ToolKnox/hawkridge-stepper-linear-actuator-28byj48/source/upstream/images/0a723f840fd063da267f98753610b76e.png

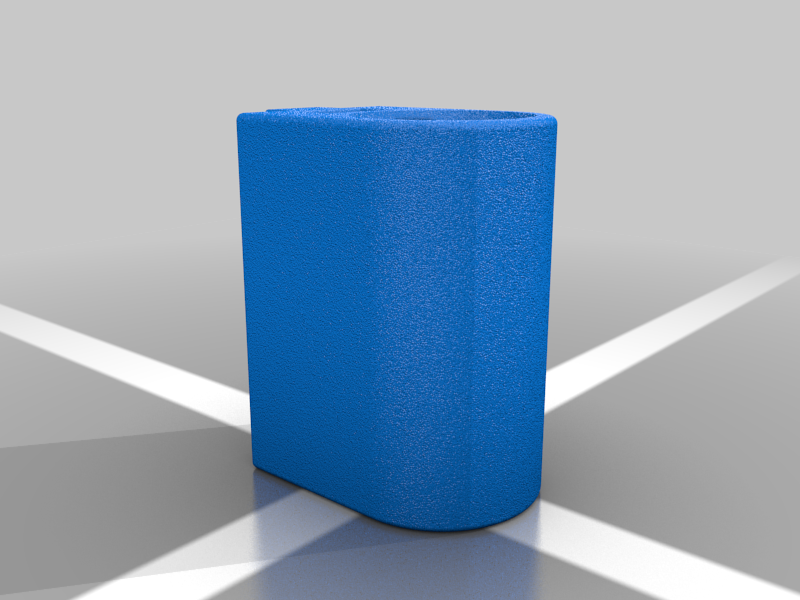
source/upstream/images/0a723f840fd063da267f98753610b76e.png
