ToolKnox/hawkridge-stepper-linear-actuator-28byj48/source/upstream/images/7eddcb1e75cd424855b5d3cada763b5f.png

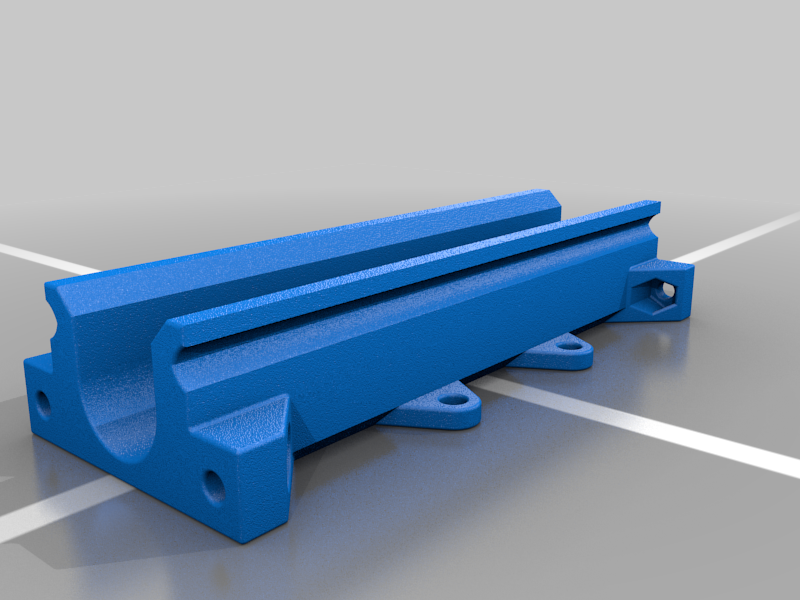
source/upstream/images/7eddcb1e75cd424855b5d3cada763b5f.png
