ToolKnox/hawkridge-stepper-linear-actuator-28byj48/source/upstream/images/86ed6450e4bb26c193aa891bc44c7ca6.png

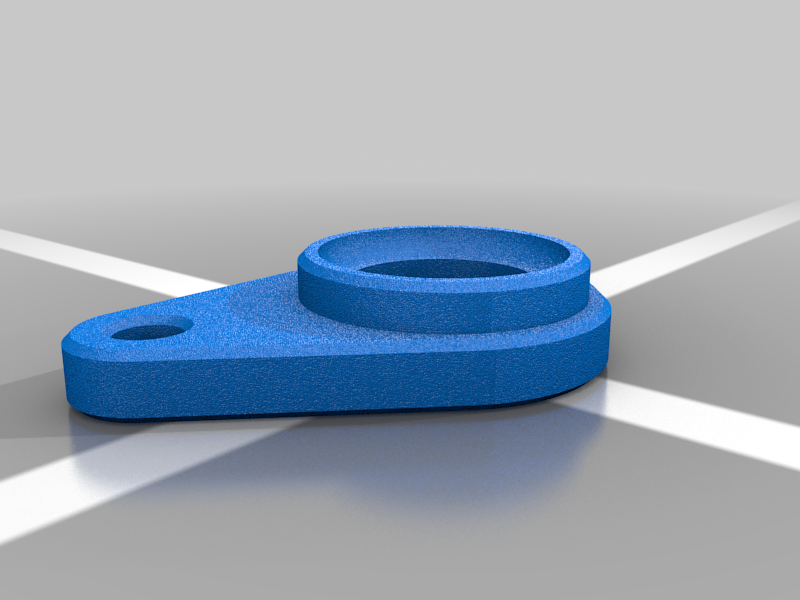
source/upstream/images/86ed6450e4bb26c193aa891bc44c7ca6.png
