ToolKnox/hawkridge-stepper-linear-actuator-28byj48/source/upstream/images/679c549c6efe19c602c5bcb0a57939a1.png

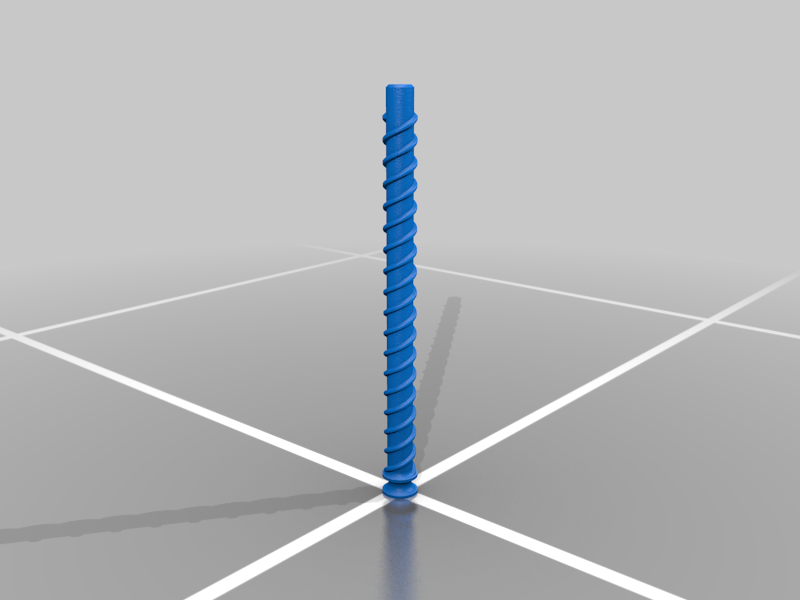
source/upstream/images/679c549c6efe19c602c5bcb0a57939a1.png
