ToolKnox/hawkridge-stepper-linear-actuator-28byj48/source/upstream/images/a1be0f932977acde7568e8e3e2db6e08.png

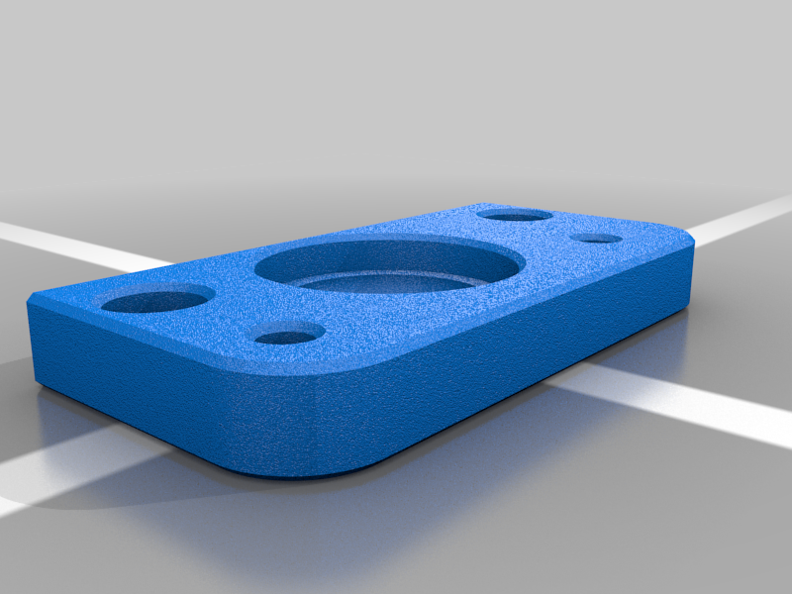
source/upstream/images/a1be0f932977acde7568e8e3e2db6e08.png
