ToolKnox/hawkridge-stepper-linear-actuator-28byj48/source/upstream/images/f5790041cac6689166ce791756fab6bf.png

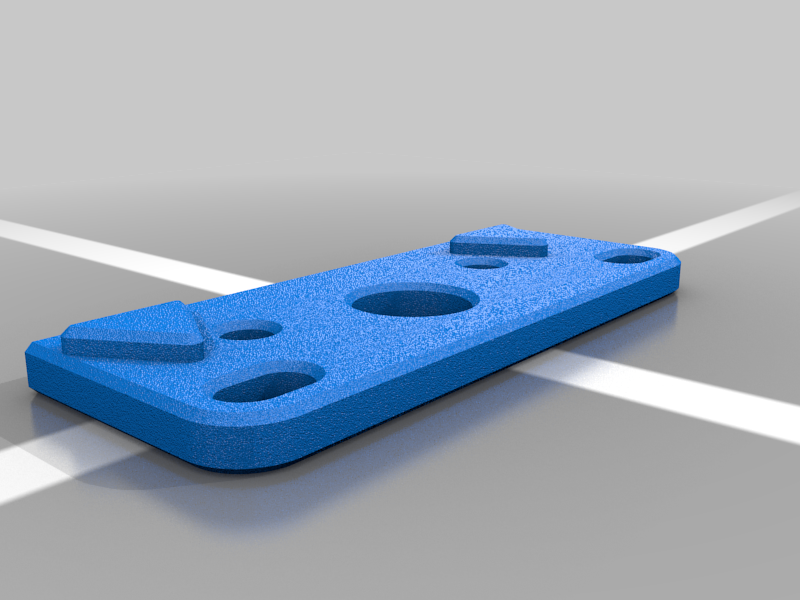
source/upstream/images/f5790041cac6689166ce791756fab6bf.png
