ToolKnox/hawkridge-stepper-linear-actuator-28byj48/source/upstream/images/fc79aa7be63a0f739bf278e467f03a53.png

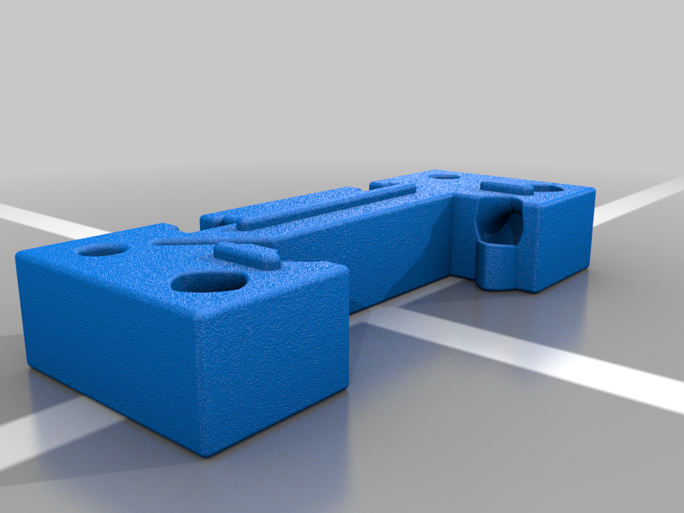
source/upstream/images/fc79aa7be63a0f739bf278e467f03a53.png
