ToolKnox/hawkridge-stepper-linear-actuator-28byj48/source/upstream/images/fd4f218f93168235e0e2fc0a6d53013b.png

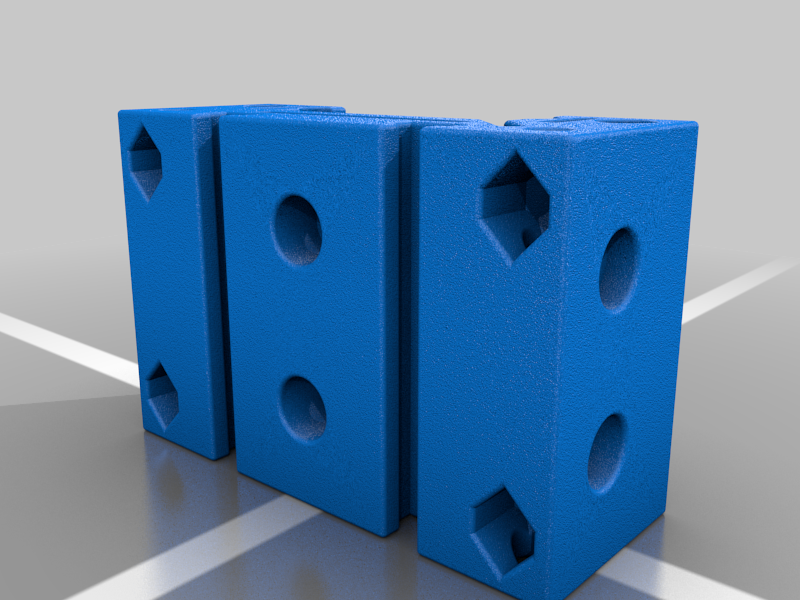
source/upstream/images/fd4f218f93168235e0e2fc0a6d53013b.png
