ToolKnox/hawkridge-stepper-linear-actuator-28byj48/source/upstream/images/IMG_7963.JPG

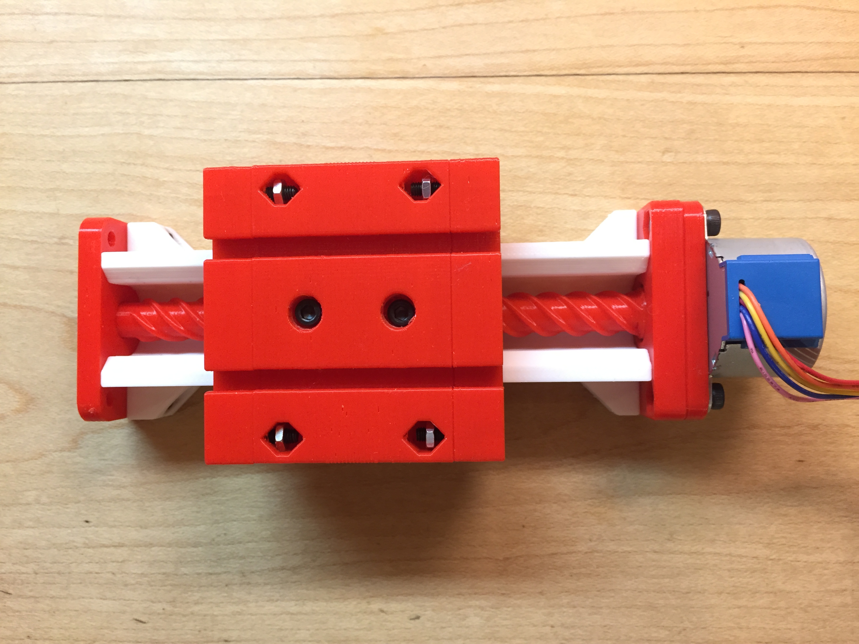
source/upstream/images/IMG_7963.JPG
