ToolKnox/hawkridge-stepper-linear-actuator-28byj48/docs/28BYJ-48 Stepper Linear Actuator with Printed Ball Screw - Bill of Material.pdf

B I L L O F M A T E R I A L S

# 28BYJ-48 Stepper Linear Actuator with Printed Ball Screw

Rev. 2026-10-20 13 items

View this project on Printables (https://www.printables.com/@TomKnox_1573/models) | Buy me a Beer (https://www.paypal.com/paypalme/TomKnox3d) | Join my club for exclusive models (https://www.printables.com/@TomKnox_1573)

BOM | Product/Project: 28BYJ-48 Stepper Linear Actuator with Printed Ball Screw
Revision date: 2026-10-20 | https://www.printables.com/@TomKnox_1573/models
MOTION | 1 items
Description | Qty | AliExpress | Amazon (Geniuslink) | Notes

>>

28BYJ-48 5V stepper motor with ULN2003 driver board

| 1 | AliExpress Link (https://s.click.aliexpress.com/s/NdpwztbAIgDMmxGbP8fFks7yUFfsHjzlImSYmA68h7xlMRgzueFsRgokQ9f9hcpVKttxtQE2VzIoqkXJXrpOr6uR3zv7mP4CDO9CddoFf4t0QE5DXPy8Pgjhz4irf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) | Amazon Link (https://geni.us/6QA7UgA) | The upstream design is built around this motor. One motor + driver per slide.

BOM | Product/Project: 28BYJ-48 Stepper Linear Actuator with Printed Ball Screw
Revision date: 2026-10-20 | https://www.printables.com/@TomKnox_1573/models
CONTROLLER | 1 items
Description | Qty | AliExpress | Amazon (Geniuslink) | Notes

>>

Arduino Nano V3 ATmega328P CH340 with soldered headers | 1 | AliExpress Link (https://s.click.aliexpress.com/s/NdpwztbAIgDMmxGbP8fFks7yUFfsHjzlImSYmA68h7xlMRgzueFsRgokQ9f9hcpVKttxtQE2VzIoqkXJXrpOr6uR3zv7mP4CDO9CddoFf4t0QE5DXPy8Pgjhz4irf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) | Amazon Link (https://geni.us/60tiiw) | Runs the example sketch; an Uno works with the same pins.

BOM | Product/Project: 28BYJ-48 Stepper Linear Actuator with Printed Ball Screw
Revision date: 2026-10-20 | https://www.printables.com/@TomKnox_1573/models
SENSORS | 1 items
Description | Qty | AliExpress | Amazon (Geniuslink) | Notes

>>

KW12-3 micro limit switch with roller lever
1 | AliExpress Link (https://s.click.aliexpress.com/s/NdpwztbAIgDMmxGbP8fFks7yUFfsHjzlImSYmA68h7xlMRgzueFsRgokQ9f9hcpVKttxtQE2VzIoqkXJXrpOr6uR3zv7mP4CDO9CddoFf4t0QE5DXPy8Pgjhz4irf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) | Amazon Link (https://geni.us/ghQs)

Endstop for homing (our addition; the upstream slide has no endstop). Mount at the motor end of the rail.

BOM | Product/Project: 28BYJ-48 Stepper Linear Actuator with Printed Ball Screw
Revision date: 2026-10-20 | https://www.printables.com/@TomKnox_1573/models
HARDWARE | 4 items
Description | Qty | AliExpress | Amazon (Geniuslink) | Notes

>>

4.5 mm steel BBs 0.177 cal 1000 pcs

1 | AliExpress Link (https://s.click.aliexpress.com/s/NdpwztbAIgDMmxGbP8fFks7yUFfsHjzlImSYmA68h7xlMRgzueFsRgokQ9f9hcpVKttxtQE2VzIoqkXJXrpOr6uR3zv7mP4CDO9CddoFf4t0QE5DXPy8Pgjhz4irf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) | Amazon Link (https://geni.us/wEVY)

Upstream: the linear bearing takes 34 + 6 BBs and the thrust bearing 8 (the short list says 8 + 8; pack
per the assembly text). Steel, not

>>

| M3 x 10 mm hex socket cap screws 50 pcs | 1 | AliExpress Link (https://s.click.aliexpress.com/s/NdpwztbAIgDMmxGbP8fFks7yUFfsHjzlImSYmA68h7xlMRgzueFsRgokQ9f9hcpVKttxtQE2VzIoqkXJXrpOr6uR3zv7mP4CDO9CddoFf4t0QE5DXPy8Pgjhz4irf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) | Amazon Link (https://geni.us/k7CVi0) | Upstream needs 12 x M3 SHCS 10 mm (end caps, flange, motor).
>> | M3 x 20 mm hex socket cap screws 50 pcs | 1 | AliExpress Link (https://s.click.aliexpress.com/s/NdpwztbAIgDMmxGbP8fFks7yUFfsHjzlImSYmA68h7xlMRgzueFsRgokQ9f9hcpVKttxtQE2VzIoqkXJXrpOr6uR3zv7mP4CDO9CddoFf4t0QE5DXPy8Pgjhz4irf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) | Amazon Link (https://geni.us/Kn8gy2) | Upstream needs 2 x M3 SHCS 20 mm for the carriage preload adjustment.
>> | M3 stainless hex nuts 100 pcs | 1 | AliExpress Link (https://s.click.aliexpress.com/s/NdpwztbAIgDMmxGbP8fFks7yUFfsHjzlImSYmA68h7xlMRgzueFsRgokQ9f9hcpVKttxtQE2VzIoqkXJXrpOr6uR3zv7mP4CDO9CddoFf4t0QE5DXPy8Pgjhz4irf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) | Amazon Link (https://geni.us/UTAFsM) | Upstream needs 14 x M3 nuts.

BOM | Product/Project: 28BYJ-48 Stepper Linear Actuator with Printed Ball Screw
Revision date: 2026-10-20 | https://www.printables.com/@TomKnox_1573/models
POWER | 2 items
Description | Qty | AliExpress | Amazon (Geniuslink) | Notes

>>

5V 2A DC power supply 5.5x2.1mm barrel plug

| 1 | AliExpress Link (https://s.click.aliexpress.com/s/NdpwztbAIgDMmxGbP8fFks7yUFfsHjzlImSYmA68h7xlMRgzueFsRgokQ9f9hcpVKttxtQE2VzIoqkXJXrpOr6uR3zv7mP4CDO9CddoFf4t0QE5DXPy8Pgjhz4irf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) | Amazon Link (https://geni.us/c0ICdD) | Powers the ULN2003 board; do not
| | | | run the motor from the Nano 5 V pin
| | | | for long.

>>

DC barrel jack 5.5x2.1mm female to screw terminal

adapter | 1 | AliExpress Link (https://s.click.aliexpress.com/s/NdpwztbAIgDMmxGbP8fFks7yUFfsHjzlImSYmA68h7xlMRgzueFsRgokQ9f9hcpVKttxtQE2VzIoqkXJXrpOr6uR3zv7mP4CDO9CddoFf4t0QE5DXPy8Pgjhz4irf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) | Amazon Link (https://geni.us/7hZiHA) | Supply to the driver board screw
| | | | terminals.

BOM | Product/Project: 28BYJ-48 Stepper Linear Actuator with Printed Ball Screw
Revision date: 2026-10-20 | https://www.printables.com/@TomKnox_1573/models
WIRING | 1 items
| Description | Qty | AliExpress | Amazon (Geniuslink) | Notes
>> | Dupont jumper wire set male-female male-male 40 pin | 1 | AliExpress Link (https://s.click.aliexpress.com/s/NdpwztbAIgDMmxGbP8fFks7yUFfsHjzlImSYmA68h7xlMRgzueFsRgokQ9f9hcpVKttxtQE2VzIoqkXJXrpOr6uR3zv7mP4CDO9CddoFf4t0QE5DXPy8Pgjhz4irf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) | Amazon Link (https://geni.us/1kAxs02) | Driver IN1-IN4 and endstop wiring.

BOM | Product/Project: 28BYJ-48 Stepper Linear Actuator with Printed Ball Screw
Revision date: 2026-10-20 | https://www.printables.com/@TomKnox_1573/models
CONSUMABLES | 2 items
Description | Qty | AliExpress | Amazon (Geniuslink) | Notes

>>

PTFE lithium grease 50 g tube
1 | AliExpress Link (https://s.click.aliexpress.com/s/NdpwztbAIgDMmxGbP8fFks7yUFfsHjzlImSYmA68h7xlMRgzueFsRgokQ9f9hcpVKttxtQE2VzIoqkXJXrpOr6uR3zv7mP4CDO9CddoFf4t0QE5DXPy8Pgjhz4irf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) | Amazon Link (https://geni.us/LElekAe)

Upstream recommends grease on the thrust bearing, drive screw and nut (not on the linear-bearing BBs).

>>

PLA filament 1.75 mm 1 kg
1 | AliExpress Link (https://s.click.aliexpress.com/s/pyFri10M6ltAv61YZY9TfrxiDaaFXRreuZWJMeLtD8jig1wPxn51K2eq59ds8iT5Wl5L3w5KJyrl7SjOO3B0oJ0Xjwnc7n8AQA7gf5qnT4sCyU05LNms9JvyWQNFH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) | Amazon Link (https://geni.us/Y9o6)

All parts print in PLA. Consumable row; printed parts are not purchase rows.

BOM | Product/Project: 28BYJ-48 Stepper Linear Actuator with Printed Ball Screw
Revision date: 2026-10-20 | https://www.printables.com/@TomKnox_1573/models
WIRING | 1 items
Description | Qty | AliExpress | Amazon (Geniuslink) | Notes

>>

Mini USB cable 1 m data

| 1 | AliExpress Link (https://s.click.aliexpress.com/s/NdpwztbAIgDMmxGbP8fFks7yUFfsHjzlImSYmA68h7xlMRgzueFsRgokQ9f9hcpVKttxtQE2VzIoqkXJXrpOr6uR3zv7mP4CDO9CddoFf4t0QE5DXPy8Pgjhz4irf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) | Amazon Link (https://geni.us/qwwTX) | Programming cable for the Nano (check whether your clone uses Mini, Micro or USB-C).
