ToolKnox/hawkridge-stepper-linear-actuator-28byj48/print-files/DT-V3-BEARING_FLANGE.stl

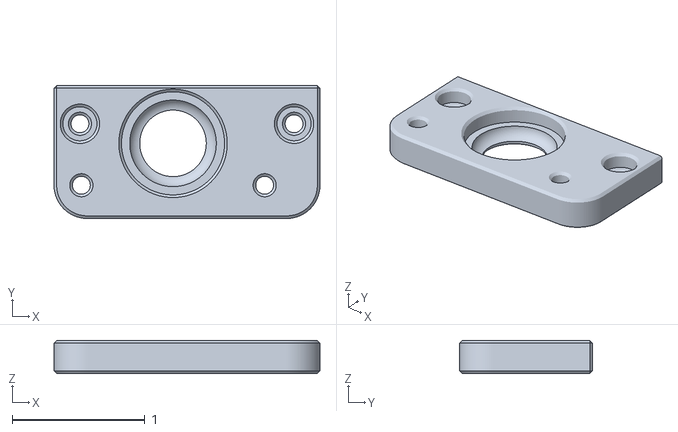
[picture p13: CAD file, 2026-10-21]
print-files/DT-V3-BEARING_FLANGE.stl
2.00 x 1.00 x 0.25
