ToolKnox/hawkridge-stepper-linear-actuator-28byj48/print-files/DT-V3-BEARING_CAP.stl

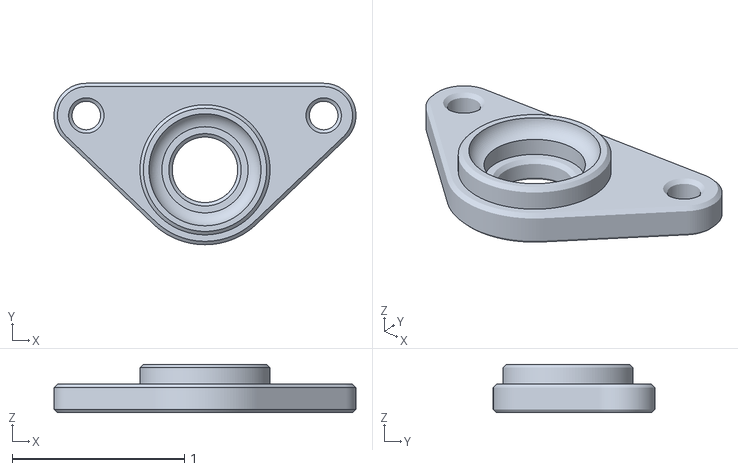
[picture p15: CAD file, 2026-10-21]
print-files/DT-V3-BEARING_CAP.stl
1.75 x 0.938 x 0.281
