ToolKnox/hawkridge-stepper-linear-actuator-28byj48/print-files/DT-V3-END_CAP.stl

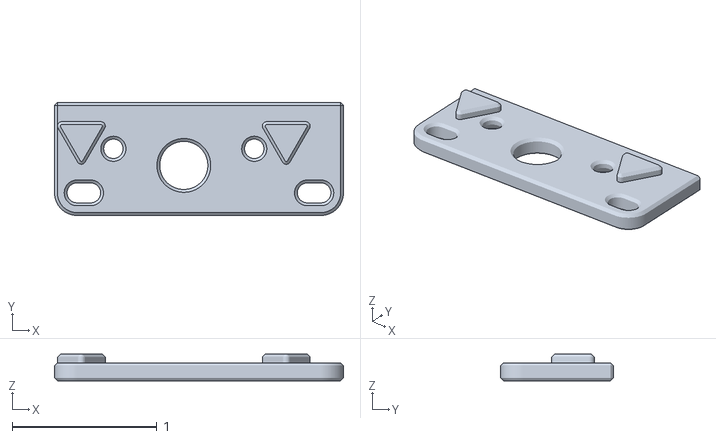
[picture p16: CAD file, 2026-10-21]
print-files/DT-V3-END_CAP.stl
2.00 x 0.781 x 0.185
