ToolKnox/hawkridge-stepper-linear-actuator-28byj48/print-files/BS-V2-CARRIAGE.stl

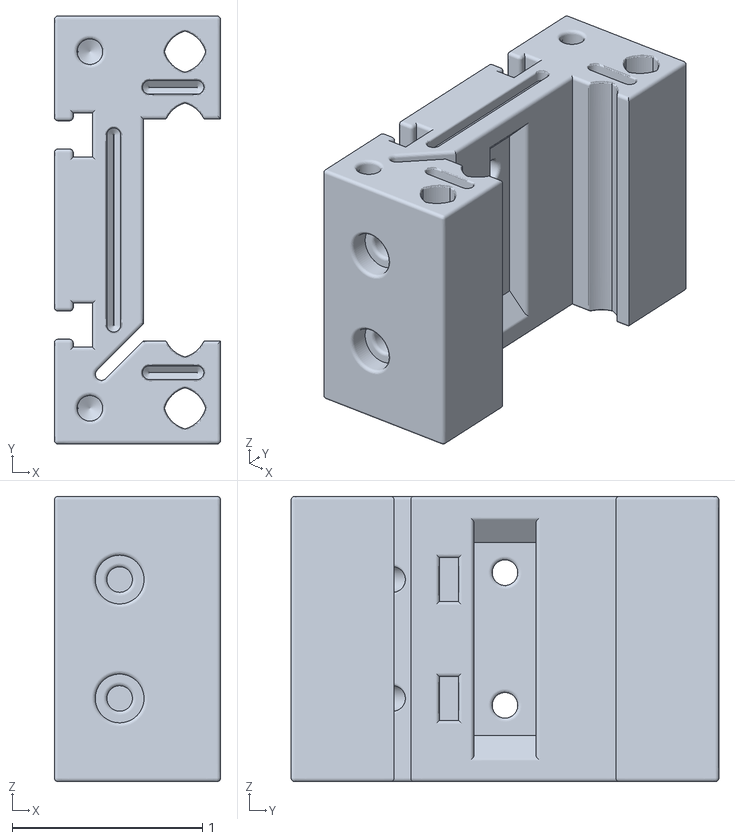
[picture p17: CAD file, 2026-10-21]
print-files/BS-V2-CARRIAGE.stl
0.875 x 2.25 x 1.50
