ToolKnox/hawkridge-stepper-linear-actuator-28byj48/print-files/BS-V2-CARRIAGE_CAP.stl

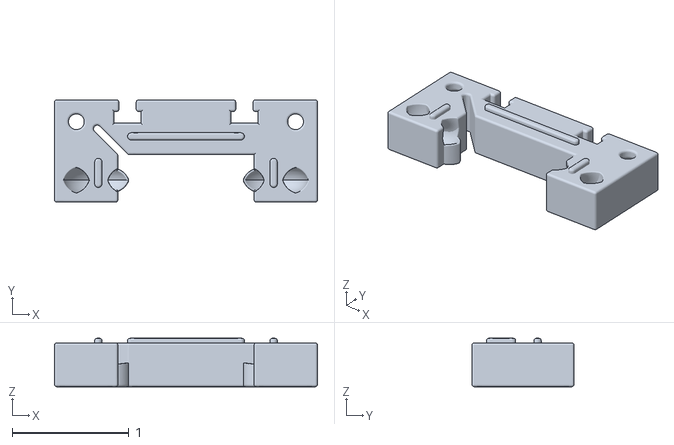
[picture p18: CAD file, 2026-10-21]
print-files/BS-V2-CARRIAGE_CAP.stl
2.25 x 0.875 x 0.415
