ToolKnox/hawkridge-stepper-linear-actuator-28byj48/print-files/BS-V2-RAIL.stl

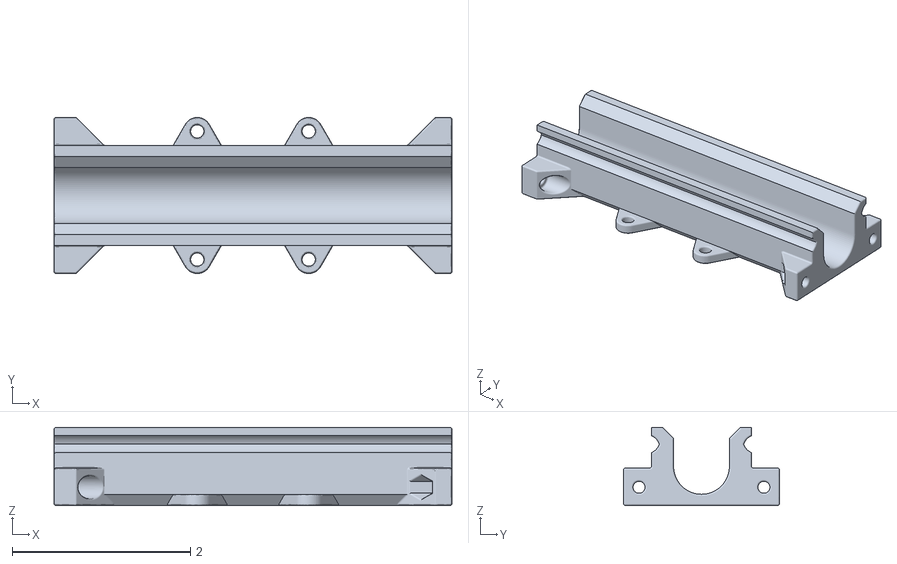
[picture p19: CAD file, 2026-10-21]
print-files/BS-V2-RAIL.stl
4.46 x 1.75 x 0.875
