ToolKnox/hawkridge-stepper-linear-actuator-28byj48/source/upstream/4703799_BS-V2-CARRIAGE.stl

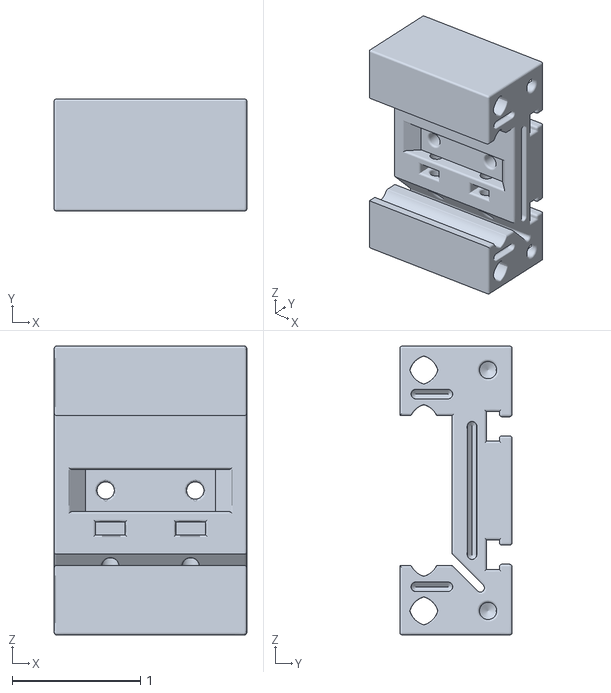
[picture p20: CAD file, 2026-10-21]
source/upstream/4703799_BS-V2-CARRIAGE.stl
1.50 x 0.875 x 2.25
