ToolKnox/hawkridge-stepper-linear-actuator-28byj48/print-files/BS-V1-SCREW-1_2-DBL.stl

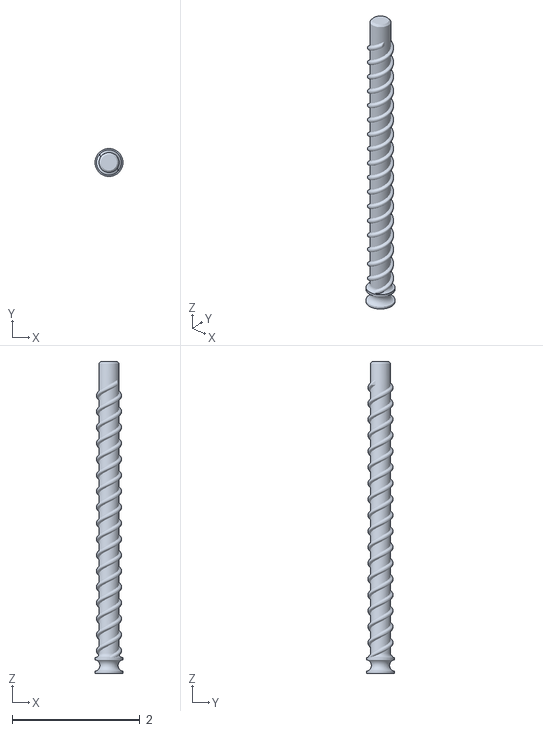
[picture p21: CAD file, 2026-10-21]
print-files/BS-V1-SCREW-1_2-DBL.stl
0.437 x 0.437 x 4.89
