ToolKnox/hawkridge-stepper-linear-actuator-28byj48/print-files/BS-V1-NUT-1.stl

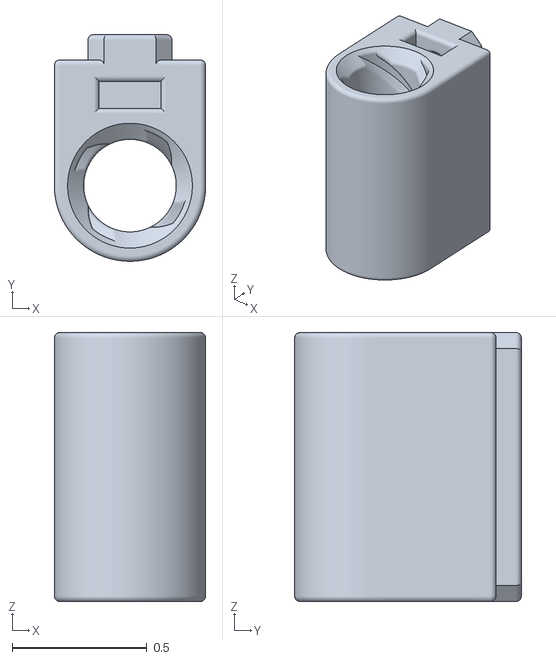
[picture p22: CAD file, 2026-10-21]
print-files/BS-V1-NUT-1.stl
0.563 x 0.843 x 1.00
