ToolKnox/hawkridge-stepper-linear-actuator-28byj48/print-files/BS-V1-SCREW-1-QUAD.stl

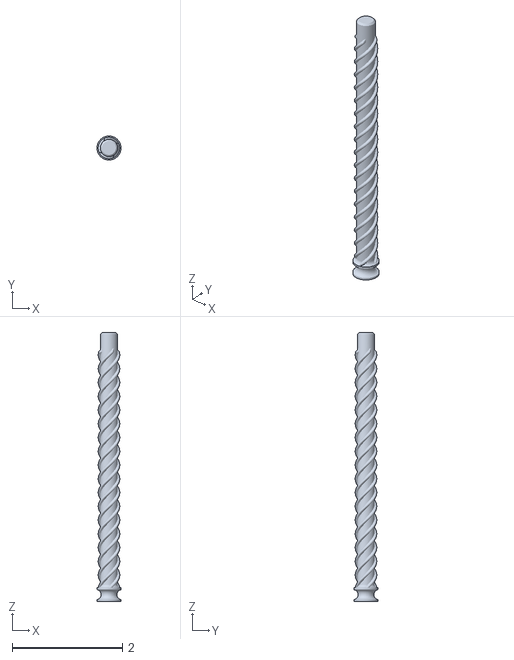
[picture p23: CAD file, 2026-10-21]
print-files/BS-V1-SCREW-1-QUAD.stl
0.437 x 0.437 x 4.89
