ToolKnox/hawkridge-stepper-linear-actuator-28byj48/(list of files, cad)

Other CAD files:
source/upstream/4703790_BS-V2-CARRIAGE_CAP-MIRROR.stl
source/upstream/4703791_BS-V2-CARRIAGE_CAP.stl
print-files/BS-V1-NUT-1_2.stl
source/upstream/4724219_BS-V1-NUT-1_2.stl
